ViIiOleTe/Self-Balance-car-based-on-arduino-/README.md

# Self-Balance-car-based-on-arduino-
self-balanced car based on arduino uno/ arduino nano esp32
