ViIiOleTe/Self-Balance-car-based-on-arduino-/Porject.pptx

## two-wheeled self-balancing ultrasonic obstacle-avoidance transport vehicle based on an Arduino microcontroller

Zihan Gao

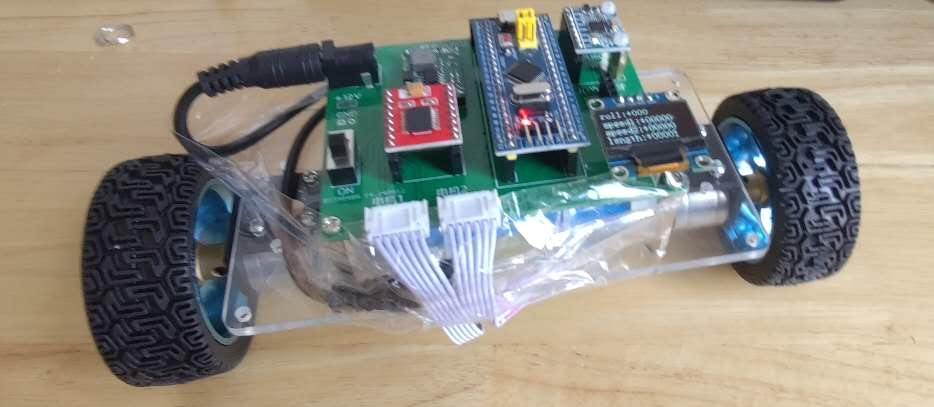
[picture p1: figure]
d728abb545b0e89e21f19de554e8f45b

I did before: Based on stm32, with no bluetooth wireless control and unbalanced, didn’t finish

## Porblem&Aim

- Problem:
- A four-wheeled transport vehicle has a large size and requires a wide space for turning, making it unsuitable for uneven terrain.
- In contrast, a two-wheeled transport vehicle is compact and highly maneuverable, capable of rotating in place and adapting to irregular ground surfaces.
- Aim:
- To place a cup of water on the vehicle and ensure that it can move flexibly without spilling the water, thereby demonstrating system stability.

## Hardware

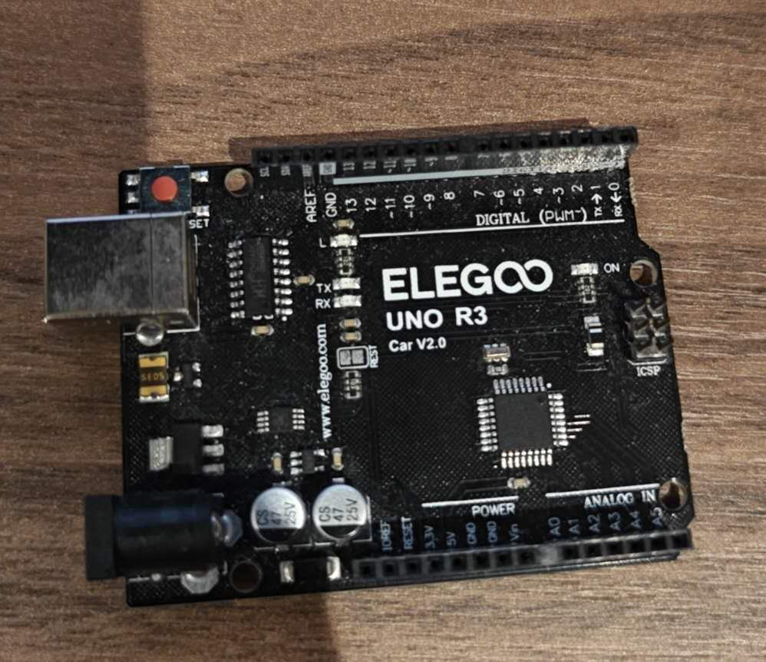
[picture p2: figure]
72d095653ce0056f9a6ff9048c9862cc

Arduino UNO

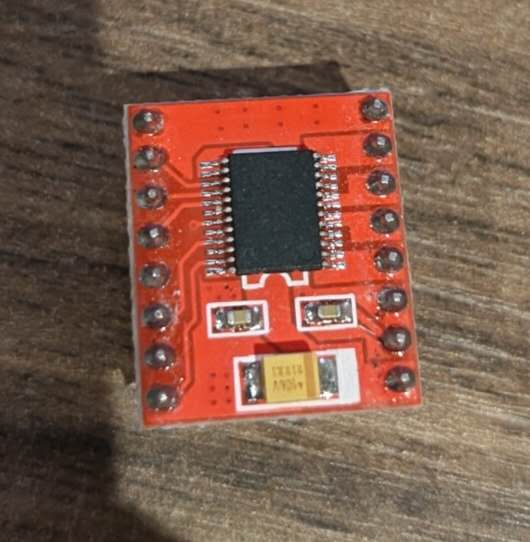
[picture p3: figure]
c2e5e653031e03f8552c2b84cbe5cb07
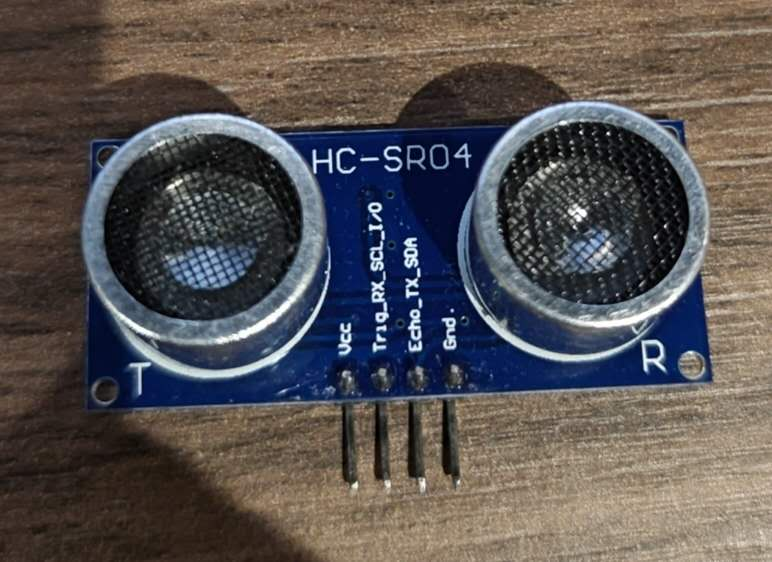
[picture p4: figure]
201b5c6c264c2540465b8942c9030292
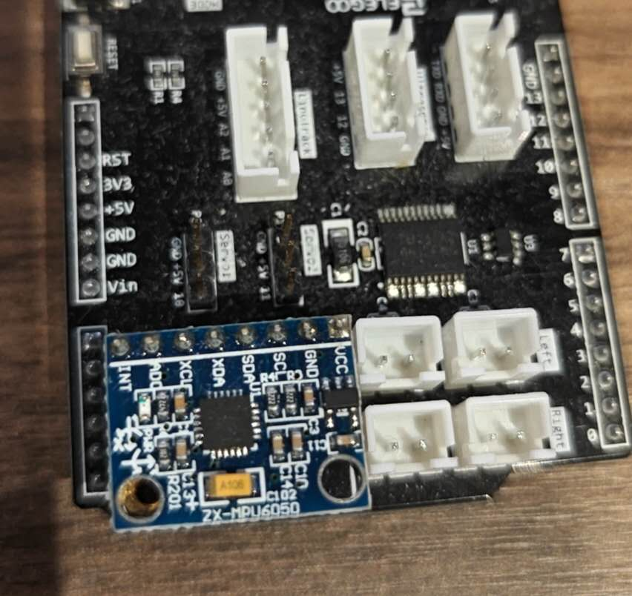
[picture p5: figure]
97aeafb40a487df97278bbed014bbf43

MPU6050 imu

TB6612 Motor Drive

HC-SRO4 ultrasonic

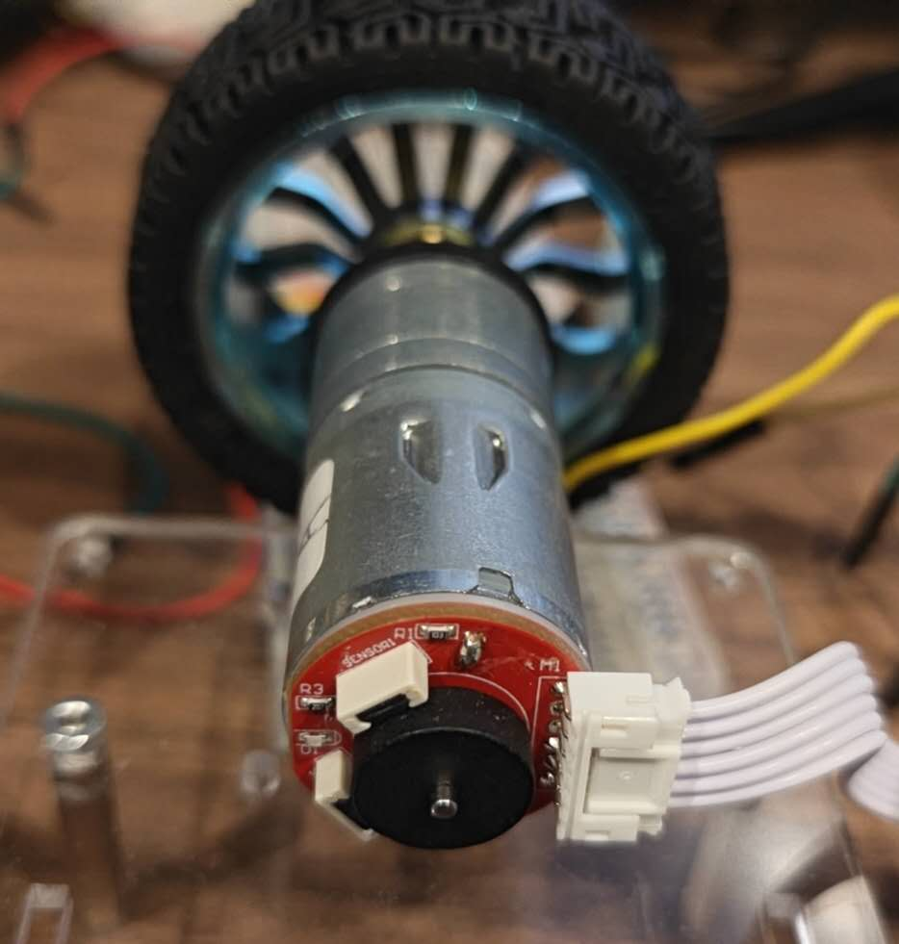
[picture p6: figure]
8adc0f342049be01004e1b45d32d1901

JGA25-370 Encoder Motor

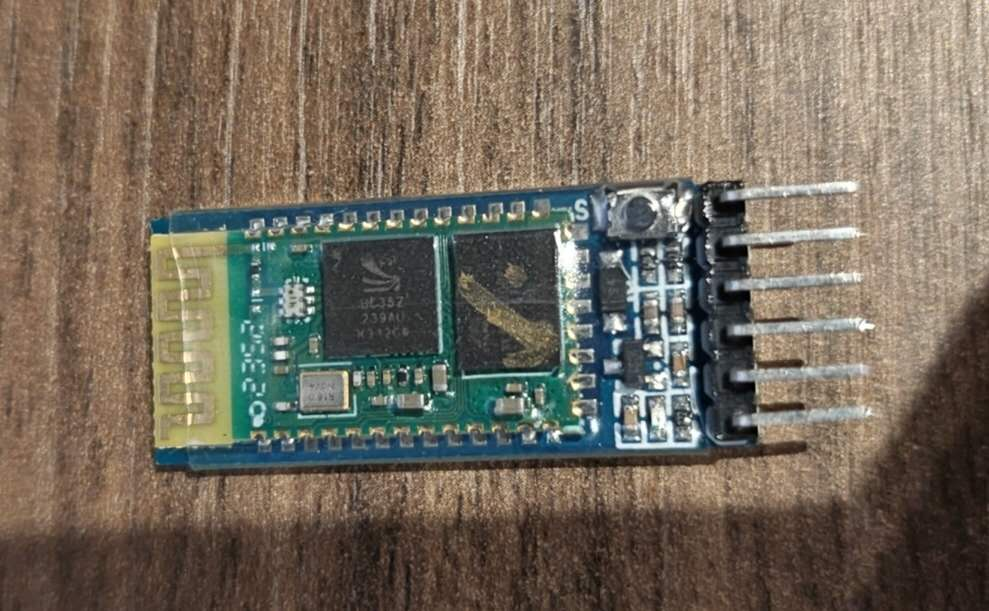
[picture p7: figure]
baf24c8be723937534e2d951f6133ec8

HC-05 bluetooth

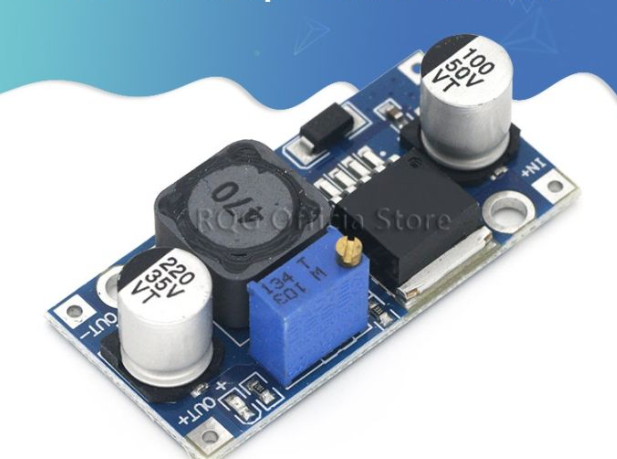
[picture p8: figure]

LM2596S voltage decrease

## Coding

Plan:
Sensing Layer:
IMU for pitch angle estimation;
Ultrasonic sensor for obstacle detection.
Control Layer:
Arduino UNO
PID control algorithm
obstacle-avoidance logic
Execution Layer:
motor driver for differential wheel control
wireless controller for user interaction

So far:

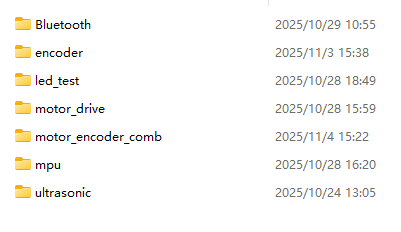
[picture p9: figure]

Next step:
PID control algorism
Rotation algorism
obstacle avoidance
and keep adusting values...

## Software require

Arduino IDE

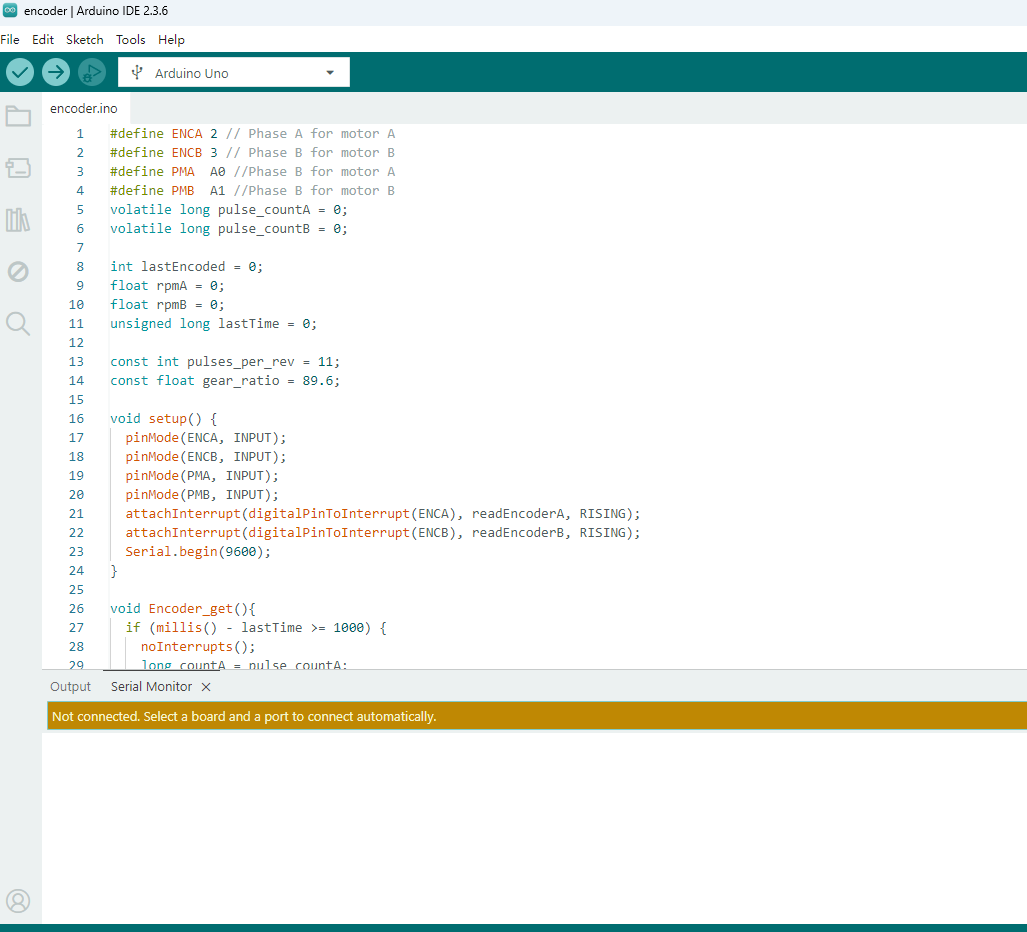
[picture p10: figure]

Android Studio

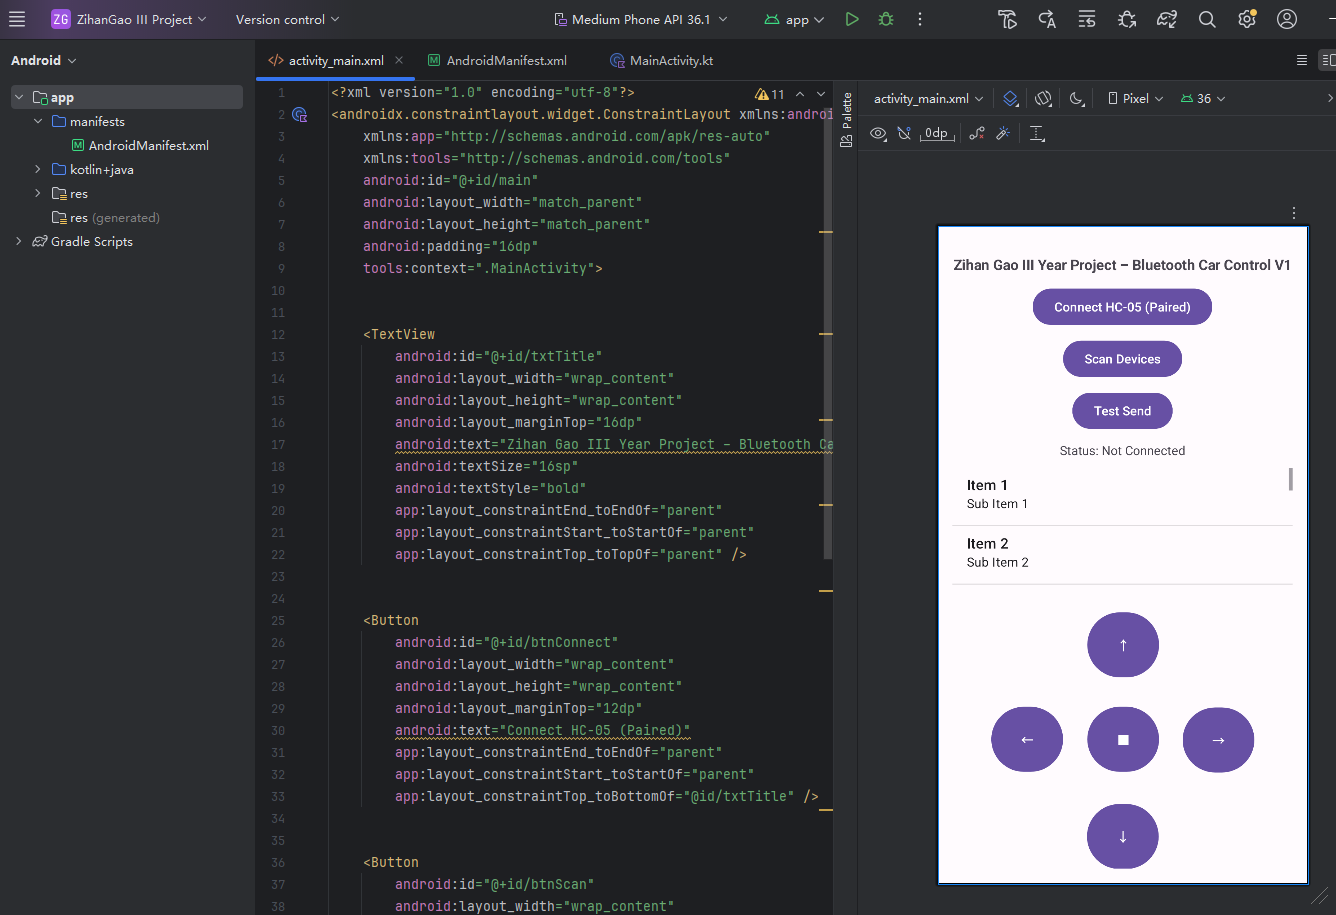
[picture p11: figure]

PCB software

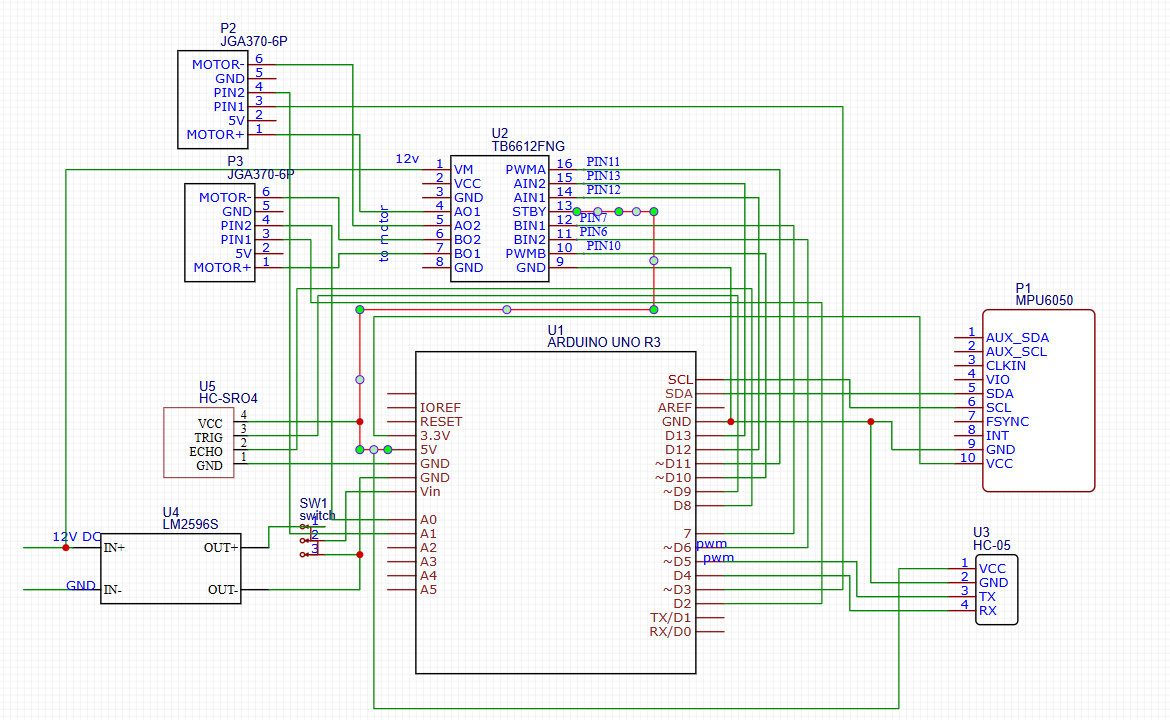
[picture p12: figure]

CAD software if needed

## schematic

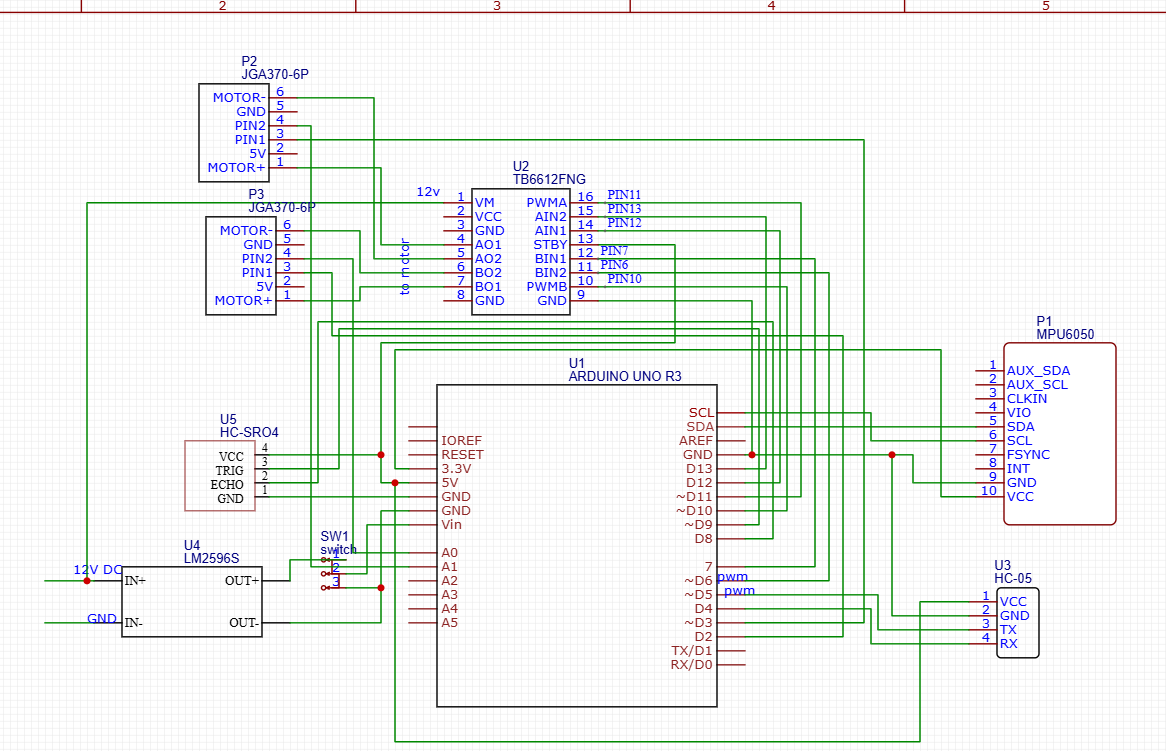
[picture p13: figure]

## Pin arrangement

Digital PIN | Connection | Function
0 | NO Connection | TX/serial communication/upload
1 | NO Connection | RX/serial communication/upload
2 | Motor A PIN1 | INT[1], encoder interrupt trigger pin
3 | Motor B PIN1 | INT[0], encoder interrupt trigger pin
4 | HC-05 RX | Blue tooth RX pin
5 | HC-05TX | Blue tooth TX pin
6 | TB6612 BIN2 | Motor B direction control
7 | TB6612 BIN1 | Motor B direction control
8 | HC-SRO4 ECHO | ultrasonic echo
9 | HC-SRO4 TRIG | ultrasonic trigger
10 | TB6612 PWMB | PWM output, Motor B speed control
11 | TB6612 PWMA | PWM output, Motor A speed control
12 | TB6612 AIN1 | Motor A direction control
13 | TB6612 AIN2 | Motor A direction control
Analogue PIN
0 | Motor A PIN2 | Use as a digital pin, working with Digital PIN 2
1 | Motor B PIN2 | Use as a digital pin, working with Digital PIN 3
2 | NO Connection
3 | NO Connection
4 | NO Connection
5 | NO Connection
Other Pin
SCL | MPU6050 SCL
SDA | MPU6050 SDA
AREF | NO Connection
IOREF | NO Connection
RESET | NO Connection
3.3V | NO Connection
5V | VCC/TB6612 STBY
Vin | LM2596S OUT+
GND | GND

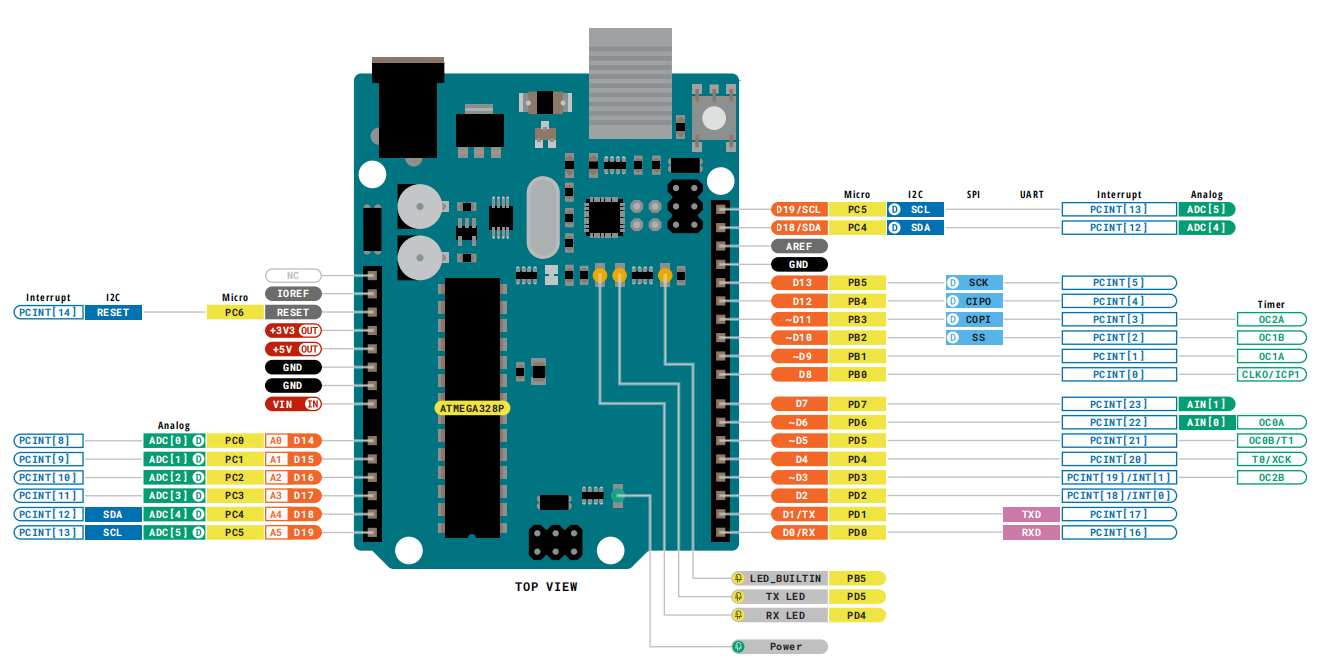
[picture p14: figure]

## Gantt Chart

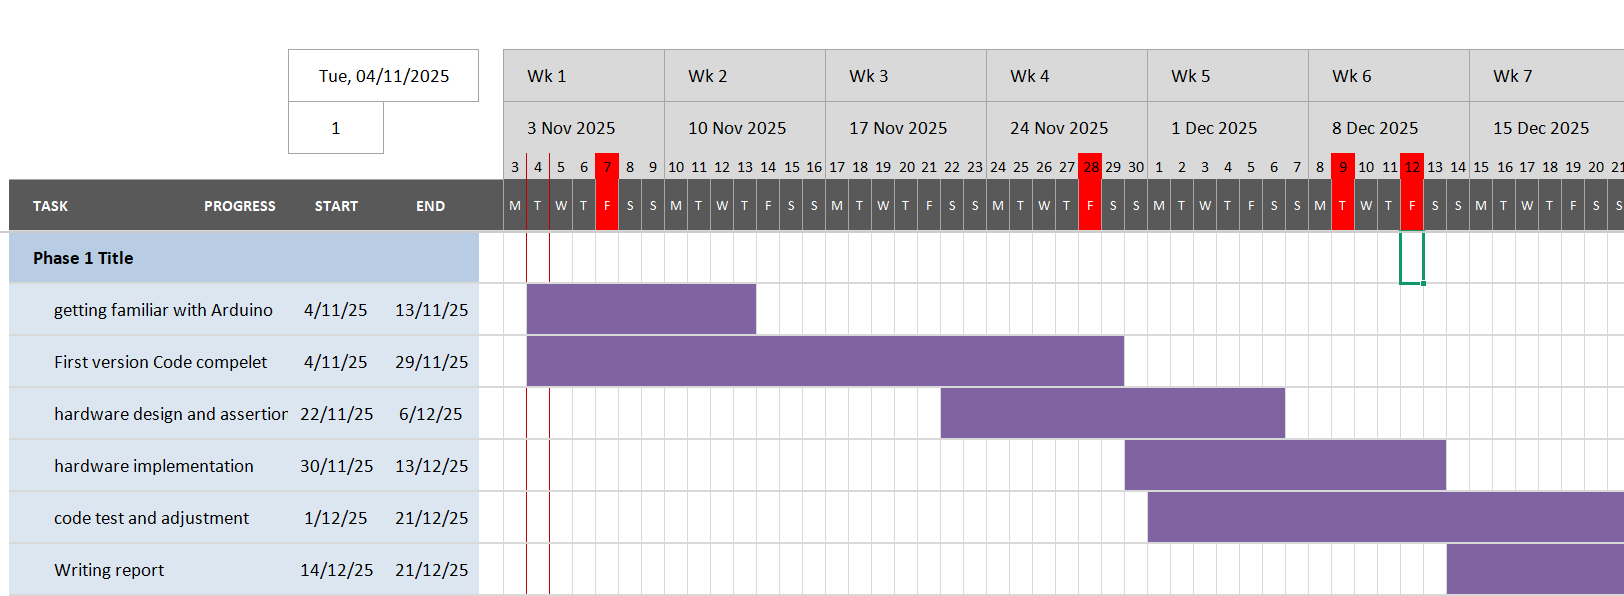
[picture p15: figure]

## Future works

- 1. PID Control Optimization and Adaptive Tuning
- 2. Obstacle Avoidance& path planning(if have time)
- 3. Data Visualization(if have time)
- 4.Hardware Upgrade(Arduino uno may not enough)
- 5. Engineering and Application Expansion: The platform can be extended into a small-scale delivery or transport robot
