ViIiOleTe/Self-Balance-car-based-on-arduino-/Zihan_Gao_brief.docx

Project title: Handheld Controller-Based Dual-Wheel Self-Balancing and Obstacle-Avoidance Robot Using Arduino UNO

Student: Zihan Gao

Supervisor: Xu Fang

Problem:

Traditional self-balancing robots often rely on fixed PID parameters and pre-defined motion patterns, lacking real-time interaction and environmental awareness. To address this limitation, this project introduces a wireless handheld controller for human-in-the-loop control and an ultrasonic distance sensor for autonomous obstacle detection, enabling responsive and safe motion in dynamic environments.

Traditional four-wheel warehouse robots often suffer from limited maneuverability, high energy consumption, and poor adaptability to uneven floors. A two-wheeled self-balancing robot offers a compact and agile alternative — using real-time attitude control and differential drive to maintain stability while achieving precise, energy-efficient movement in narrow spaces.

Aims:

1. Design and build a dual-wheel differential self-balancing robot based on Arduino UNO.
2. Implement real-time attitude estimation using MPU6050 IMU with complementary or Kalman filtering.
3. Develop a PID control algorithm for self-balancing and moving.
4. Integrate a 2.4 GHz wireless controller for intuitive real-time operation.
5. Incorporate an ultrasonic sensor for forward obstacle detection and avoidance.
6. Evaluate the system’s stability, responsiveness, and safety under varying load and environmental conditions.

Scope:

The project covers sensor fusion, control algorithm development, hardware integration, and experimental validation.

Sensing Layer:

IMU for pitch angle estimation;

Ultrasonic sensor for obstacle detection.

Control Layer:

Arduino UNO

PID control algorithm

obstacle-avoidance logic

Execution Layer:

motor driver for differential wheel control

wireless controller for user interaction

If an obstacle is detected within a set distance, the robot will slow down, stop, or re-route to avoid collision.
Indoor experiments will demonstrate balance stability, control responsiveness, and safe navigation.
