ViIiOleTe/Self-Balance-car-based-on-arduino-/protfolio1-2.pdf

Flow-Diagram

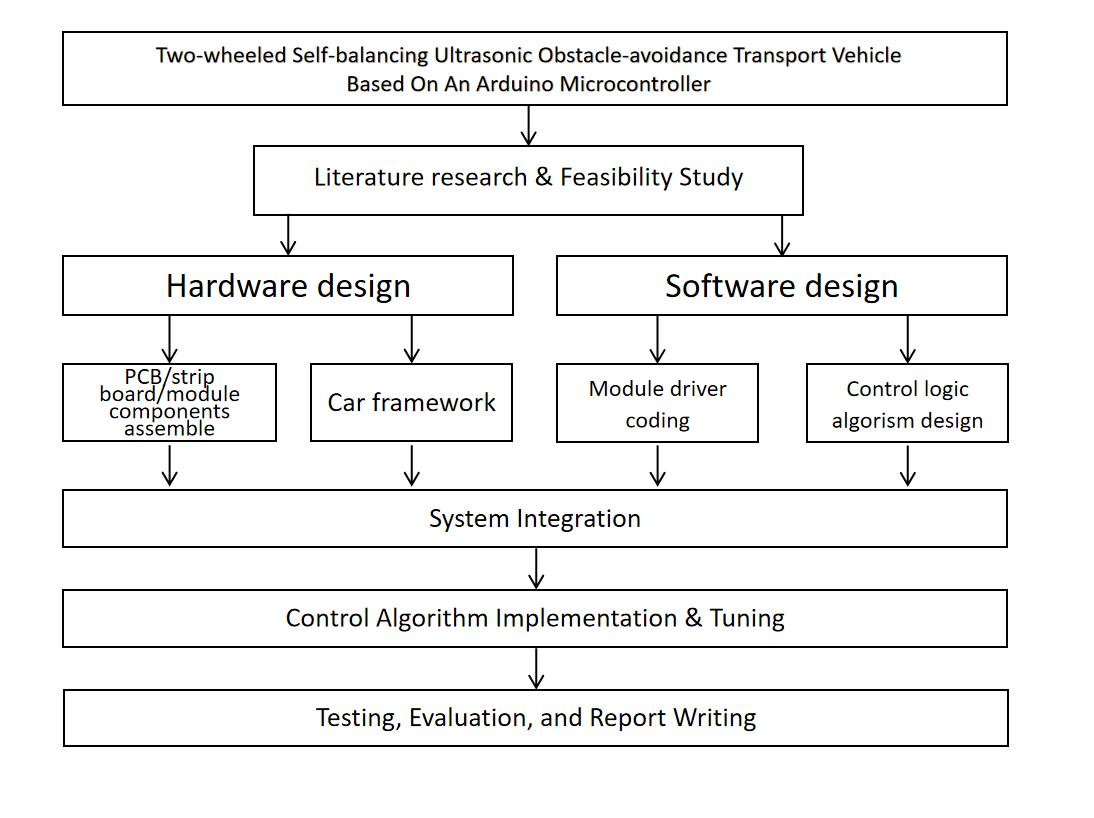
[picture p39: figure]

Milestone

Month | Milestone / Activity | Description
Oct-25 - Nov-25 | Modular Components coding/PID algorism design | Research self-balancing control principles, finalize hardware modules (Arduino, TB6612, MPU6050, HC-SR04, HC-05, encoders). PID algorism design
Nov(mid)-25 to Dec-25 | Hardware design and assembly & individual module testing | Complete car framework, circuits wiring and verify each component: motor driver, encoder, Bluetooth, ultrasonic, MPU. System integration and
| tuing System integration & | Tune the PID controller for balance; test with collected IMU data. Jan-26
| turning algorithm Full-system testing & | Integrate subsystems into one codebase; implement direction and movement control logic, obstacle avoidance. Feb-26
| optimization Final documentation & | Test obstacle avoidance, balance stability, and response on different terrains; adjust parameters. Mar-26
| demonstration | Complete final report, prepare presentation, and demonstrate working prototype.
