ViIiOleTe/Self-Balance-car-based-on-arduino-/main_uno_final/read_me.txt

此版本为整合中断函数和蓝牙连接。
main loop中5ms控制使用while判断中断标志位，测量每个模块执行时长并打印。
